DresdenGman/code-rain-ring/docs/design_notes_v7.md

# CodeRain v7 (size M, ID 20.6 ≈ US 11)
- Display: 0.66" 64x48 SSD1306 white, panel 18.46 (Y) x 18.1 (X) x 1.25, 28-pin 0.65 FPC folding down from the −X edge to the back of the panel
- Face 25.2x21.8 (ratio 1.16 ≈ reference 21x18), metal bezel ≈1.1; parallel sides, head 4.5 above the bore
- Display pocket 18.8x18.9x1.3 (z13.1–14.4); cover recess 23.0x19.6 R1.2, depth 0.4
- Battery cavities y±9.8~11.8, z5.0~13.05, length 20.2; holds 020815 (body 15, no protection board, tabs ≈6 bent); 0.05 gap between battery top and display pocket floor
- PCB 19.6x19.2x0.4 at z12.4–12.8; magnetic socket Φ4.1 at the centre of the bottom lid
- Volume: body 3199.7 + lid 189.6 = 3389 mm³; shell weight 316L ≈27 g / Ti ≈15 g / 925 silver ≈35 g, + parts ~2.5 g (est)
- I2C wiring: BS0=0 BS1=1 BS2=0, CS#=GND, D/C#=GND (0x3C), D0=SCL, D1+D2=SDA; VBAT to battery (internal charge pump)
- Battery: the cavity fits at most ~2.0x8x(≤17 body); thicker needs a wider face or thinner outer wall; 020815 is still recommended
