DresdenGman/code-rain-ring/hardware/L/v10_L_glass_outline.png

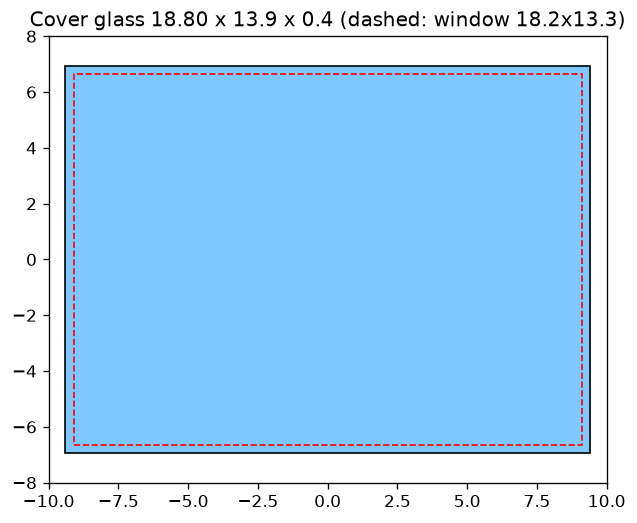
hardware/L/v10_L_glass_outline.png
