DresdenGman/code-rain-ring/hardware/L/v10_L_strip_flat.png

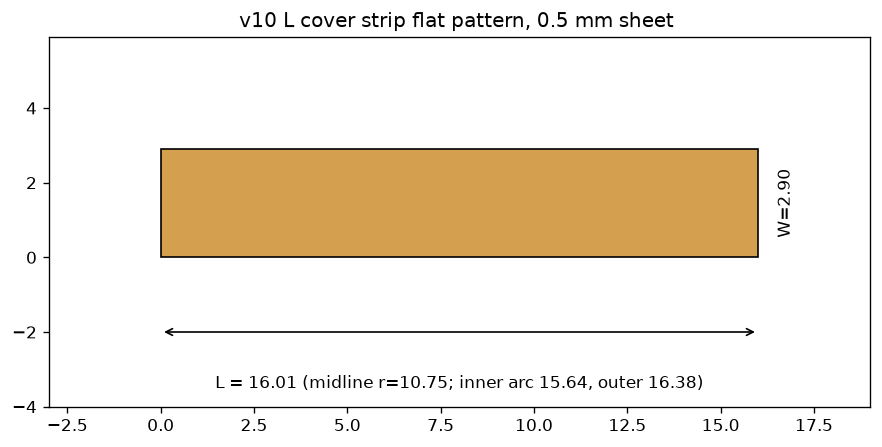
hardware/L/v10_L_strip_flat.png
