DresdenGman/code-rain-ring/hardware/M/v10_M_glass_outline.png

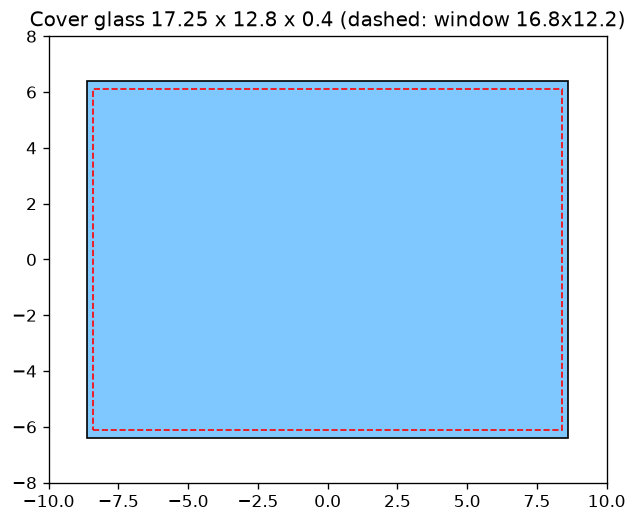
hardware/M/v10_M_glass_outline.png
