DresdenGman/code-rain-ring/hardware/M/v10_M_strip_flat.png

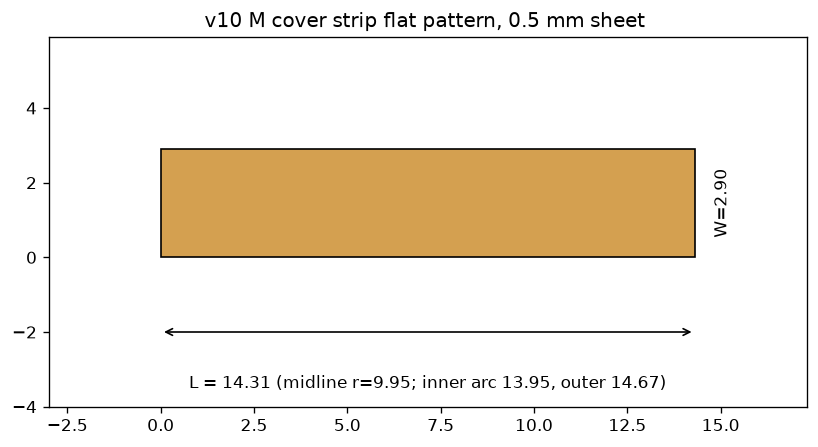
hardware/M/v10_M_strip_flat.png
