DresdenGman/code-rain-ring/renders/v10_L_exploded.png

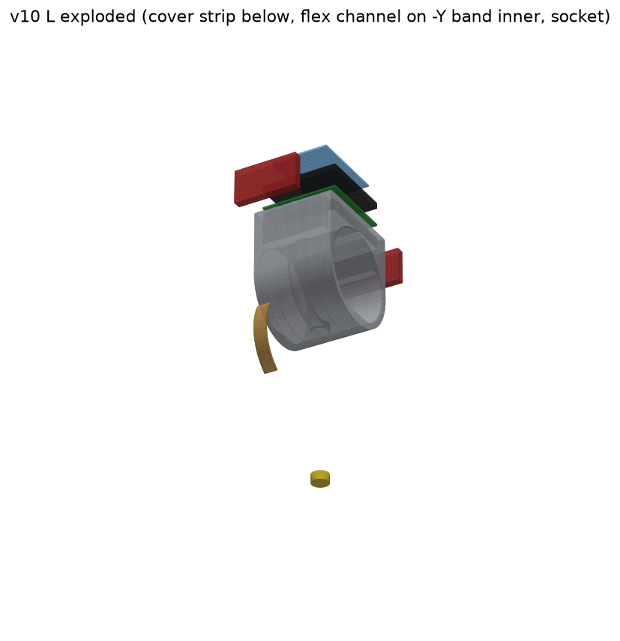
renders/v10_L_exploded.png
