DresdenGman/code-rain-ring/renders/v10_L_iso.png

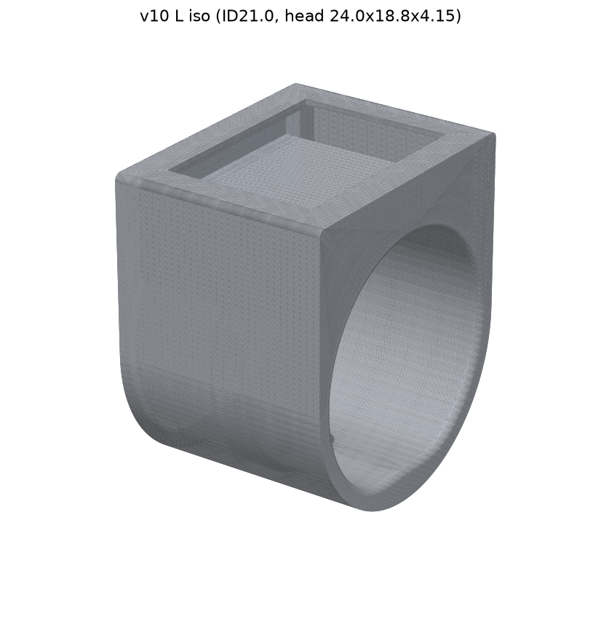
renders/v10_L_iso.png
