DresdenGman/code-rain-ring/renders/v10_L_pad.png

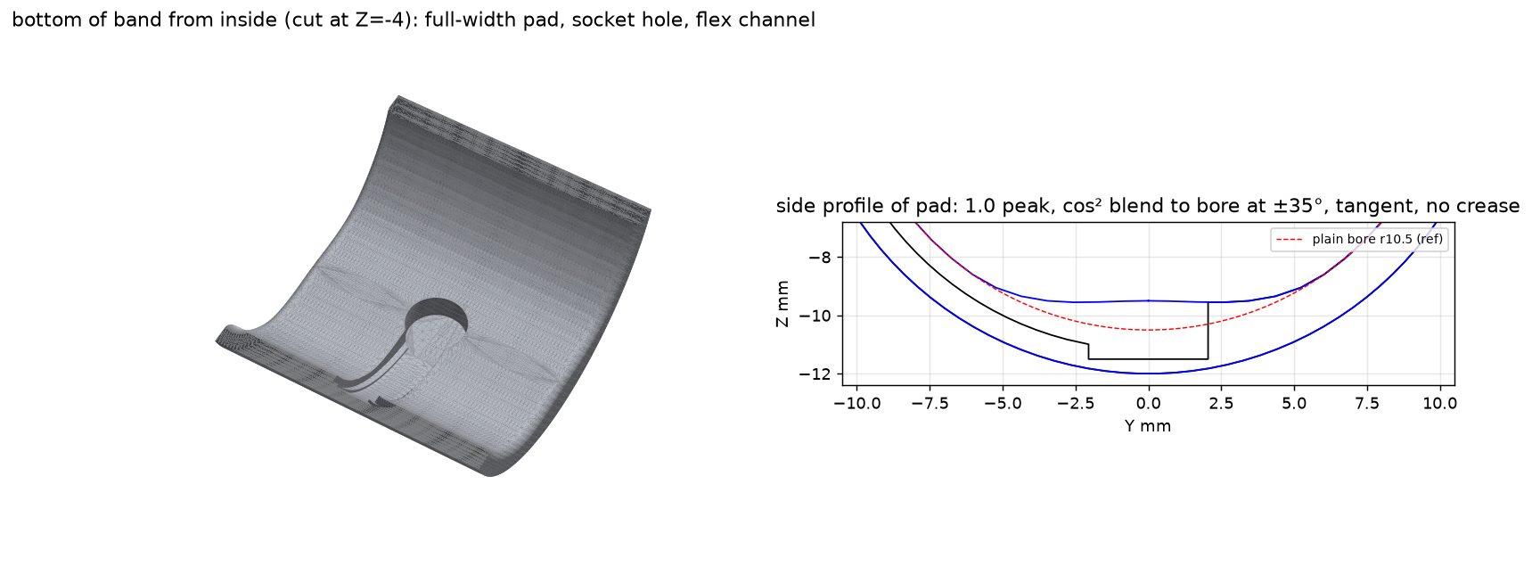
renders/v10_L_pad.png
