DresdenGman/code-rain-ring/renders/v10_L_top.png

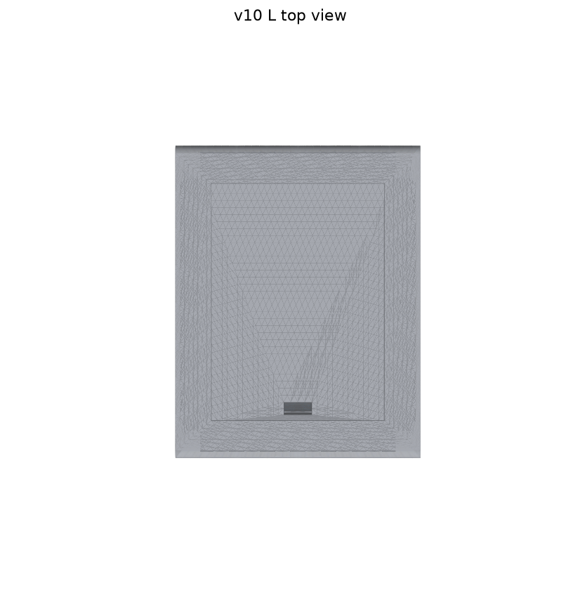
renders/v10_L_top.png
