DresdenGman/code-rain-ring/archive/bom/BOM_v1_final.csv

Category | Ref/Purpose | Part | Package/Size (mm) | Qty | LCSC number or Taobao keyword | Est. unit price | Notes
MCU | U1 | ATtiny1616-MNR (tinyAVR 1-series no radio) | QFN-20 3x3x0.9 | 1 | C507118 | ~CNY 4-6 | Runs directly from LiPo at 1.8-5.5V; power-down sleep ~0.1µA; Arduino: megaTinyCore; single-wire UPDI programming (test points on PCB)
MCU alt | U1 | CH32V003F4U6 | QFN-20 3x3 | 0 | C5299908 | ~CNY 0.6 | Cheap; official Arduino core; but min. operating voltage 2.7V (little margin at end of LiPo discharge) and higher standby current than ATtiny -> alternative
Wake | U2 | SC7A20 3-axis accelerometer (tap/double-tap interrupt -> MCU INT) | LGA-12 2x2x1 | 1 | C19274408 | ~CNY 1 | Chinese part; register-compatible with LIS2DH12
Wake alt | U2 | LIS2DH12TR | LGA-12 2x2x1 | 0 | C110926 | ~CNY 3-5 | ST original
Charging | U3 | TP4054 linear charger ~15mA | SOT-23-5 | 1 | C382138 | ~CNY 0.3 | R_PROG=68kΩ (estimate I≈1000V/R)
Program resistor | R1 | 68kΩ 1% 0402 | 0402 | 1 | LCSC basic library | —
Battery protection | U4/U5 | XB5353A single-chip protection (built-in MOSFET) | SOT-23-5 | 2 | C80628 | ~CNY 0.3 | One per cell
LDO | U6 | XC6206P302MR 3.0V low quiescent (~1µA) | SOT-23 | 1 | LCSC search XC6206P302MR | ~CNY 0.2 | Supplies OLED/MCU/accelerometer; confirm part number before ordering
Input protection | D1 | Schottky diode in series with VIN | SOD-923/0201 | 1 | LCSC basic library | — | Magnetic contacts go to VIN; not directly to the battery
ESD | D2 | ESD TVS 5V | 0201/SOD-882 | 1 | LCSC basic library | —
Display | DS1 | Zhongjingyuan 0.66in OLED 64x48 white bare panel ST7315 14-pin solder FPC | Panel 16.5x16.2x1.23 (±0.2) cap 16.5 polarizer 15.9 VA 14.42x11.06 AA 13.42x10.06; FPC neck 7.5 tail 9.0 extends 10.5; 14 pins pitch 0.62 (span 8.06) finger width 0.32 | 1 | Taobao: Zhongjingyuan Electronics 0.66in OLED 64x48 14pin solder | ~CNY 8-12 (est.) | v1 frozen; FPC exits the -X edge of the panel and folds under it; drag-soldered to 14 pads on the PCB top; VDD 2.4-3.3V; internal boost VBAT 3.5-4.2V
Charging port | J1 | WIRE cx-4mm-jz 4mm round magnetic receptacle (on hand) | Φ4 x 2.0 (rear step Φ3.7) face: outer ring Φ2.2 (−) centre pin Φ1 (+) | 1 | Pinduoduo/Taobao: 4mm round magnetic receptacle cx-4mm | — | Fits the Φ4.1 hole in the bottom lid; face toward the finger; rear pads soldered to the PCB bottom; matching USB magnetic cable (on hand)
Battery | BT1/BT2 | LIP-020815 LiPo 3.7V 9mAh | 2.0x8x15 (cell body 15 excluding protection board; tabs ~6 bent) | 2 | 1688: 200815 lithium battery / https://www.1688.com/industry/-ib9mk6.html | ~CNY 12 each | One per side battery cavity (y=±9.5~11.5 z5.6~13.9 cavity length 19.0); total length with tabs bent ≤18; no protection board; verify with samples
PCB | PCB1 | JLCPCB 4- or 2-layer FR-4 0.4mm ENIG | 18.6x18.6 R0.8 thickness 0.4 | 1 | JLCPCB order + SMT assembly | ~CNY 50-150 per 5 prototypes (est.) | Top: 14 FPC pads pitch 0.62 pad 0.36x1.6 (span 8.06 pad area ≈8.4 wide); bottom: components + receptacle pads; battery pads on the ±Y sides
Shell | — | Body + bottom lid metal 3D print | See deliver/CodeRain_v8_metal_print.zip | 1 set | Metal 3D printing service | Quote pending
Cover | — | Glass/sapphire cover 21.2x17.6 R1.2 t0.4 black border printed on back (clear window ≈13.8x10.4) | 21.2x17.6x0.4 | 1 | Taobao: custom small sapphire/tempered glass with printed black border | Quote pending
Not used | — | TTP223 / button / USB-C | — | 0 | — | — | Not used in v1: no button hole in the shell; the only opening is the magnetic charging port
OLED support | C1(C1P-C1N) C2(C2P-C2N) | Charge pump capacitor 1µF 16V X5R | 0402 | 2 | C52923 | ~CNY 0.01 | SSD1306 internal charge pump; VBAT directly from battery (3.3-4.2V)
OLED support | C3 | VCOMH capacitor 4.7µF X5R | 0402 | 1 | C23733 | ~CNY 0.02 | VCOMH to GND
OLED support | C4 | VCC decoupling 4.7µF (charge pump output ≈7.5V; choose ≥10V/16V) | 0402 | 1 | C23733 | ~CNY 0.02 | VCC to GND close to the FPC pads
OLED support | C5 C6 | VDD/VBAT decoupling 1µF | 0402 | 2 | C52923 | ~CNY 0.01 | VDD 1µF; VBAT (internal boost needs 3.5-4.2V; direct from battery; below 3.5V brightness drops / screen off)
OLED support | C7 C8 | VDD/VBAT 0.1µF | 0402 | 2 | C1525 | ~CNY 0.01
OLED support | R2 | IREF resistor 560kΩ 1% (optional; most ST7315 panels can use internal IREF; fit or not per panel datasheet) | 0402 | 1 | LCSC search 0402WGF5603TCE (number not checked) | ~CNY 0.01 | Value per panel datasheet (typically 390k-910k); the delivered panel's datasheet governs
OLED support | R3 C9 | RES# reset RC: 10kΩ pull-up + 0.1µF | 0402 | 1 | R:C25744 / C:C1525 | — | RES# to an MCU GPIO (software reset ≥3µs); RC ensures power-on reset
OLED support | R4 R5 | I2C pull-ups 4.7kΩ | 0402 | 2 | C25900 | ~CNY 0.01 | SCL/SDA shared with the accelerometer
OLED support | — | BS strapping (I2C mode) | — | 0 | — | — | The 14-pin version only exposes I2C: interface mode / CS# / SA0 fixed inside the panel; address usually 0x3C (per seller data)
OLED support | J2 | FPC pads 14-pin solder type pitch 0.62 | Pad 0.36x1.6 span 8.06 | 0 | — | — | Pinout (Zhongjingyuan drawing): 4 C1P 5 VBAT 6 NC 7 VSS 11 SDA 12 IREF 13 VCOMH 14 VCC; 1-3/8-10 not captured in the drawing; by convention presumed 1-3=C2P/C2N/C1N 8 VDD 9 RES# 10 SCL -- get the full pinout from the seller before ordering
Passives | Others | TP4054/LDO/accelerometer decoupling etc | 0402 | 6 | C1525/C52923 | — | All LCSC numbers are common basic-library parts; verify on LCSC before ordering
