DresdenGman/code-rain-ring/hardware/L/v10_L_socket.stl

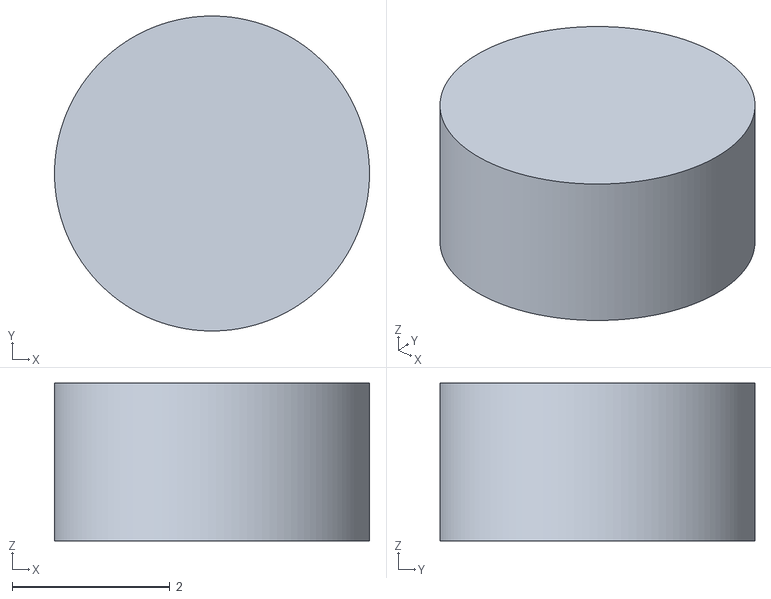
[picture p37: CAD file, 2026-11-03]
hardware/L/v10_L_socket.stl
4.00 x 4.00 x 2.00
