DresdenGman/code-rain-ring/hardware/M/v10_M_strip.step

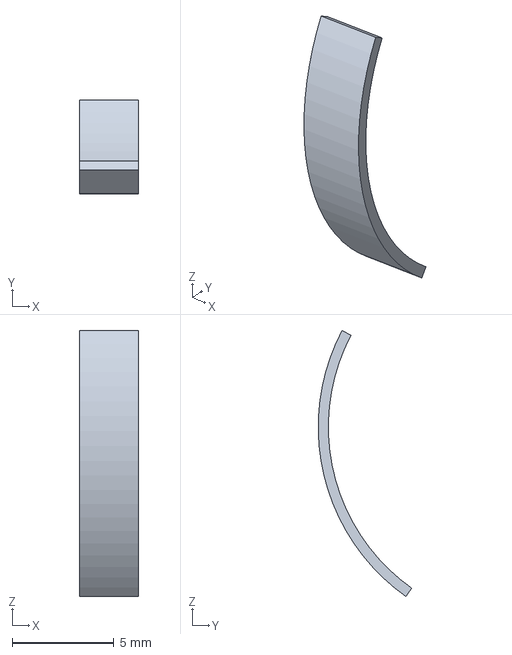
[picture p38: CAD file, 2026-11-03]
hardware/M/v10_M_strip.step
2.90 x 4.59 x 13.1 mm
