DresdenGman/code-rain-ring/hardware/L/v10_L_oled.stl

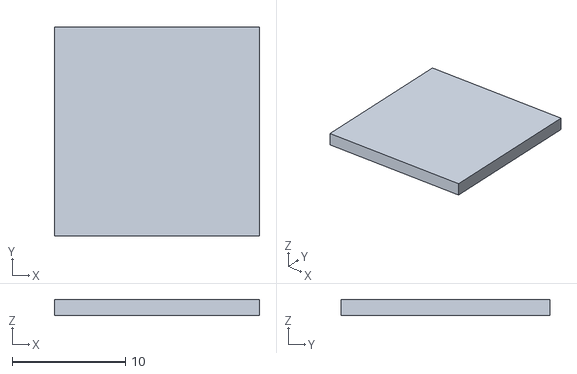
[picture p39: CAD file, 2026-11-03]
hardware/L/v10_L_oled.stl
18.1 x 18.5 x 1.45
