DresdenGman/code-rain-ring/hardware/M/v10_M_bat_L.stl

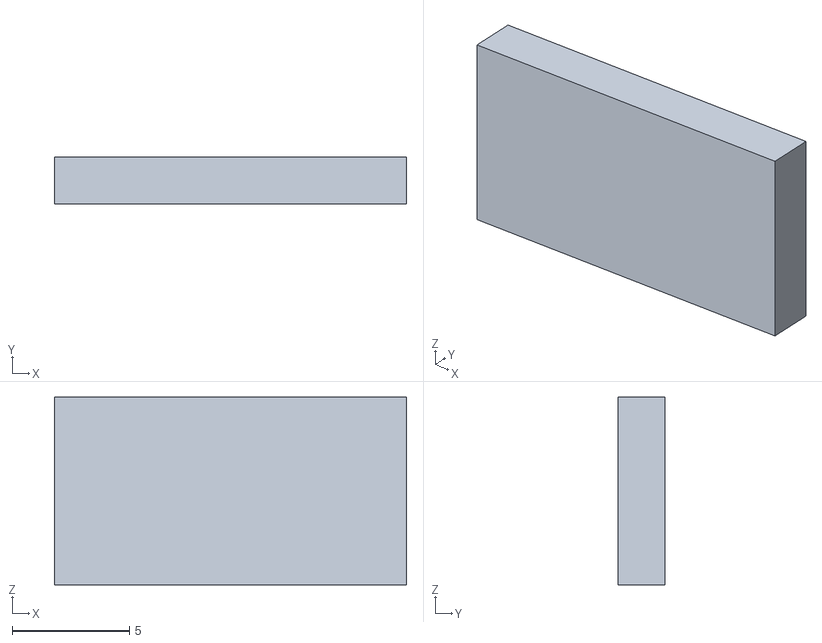
[picture p40: CAD file, 2026-11-03]
hardware/M/v10_M_bat_L.stl
15.0 x 2.00 x 8.00
