DresdenGman/code-rain-ring/hardware/L/v10_L_shell.step

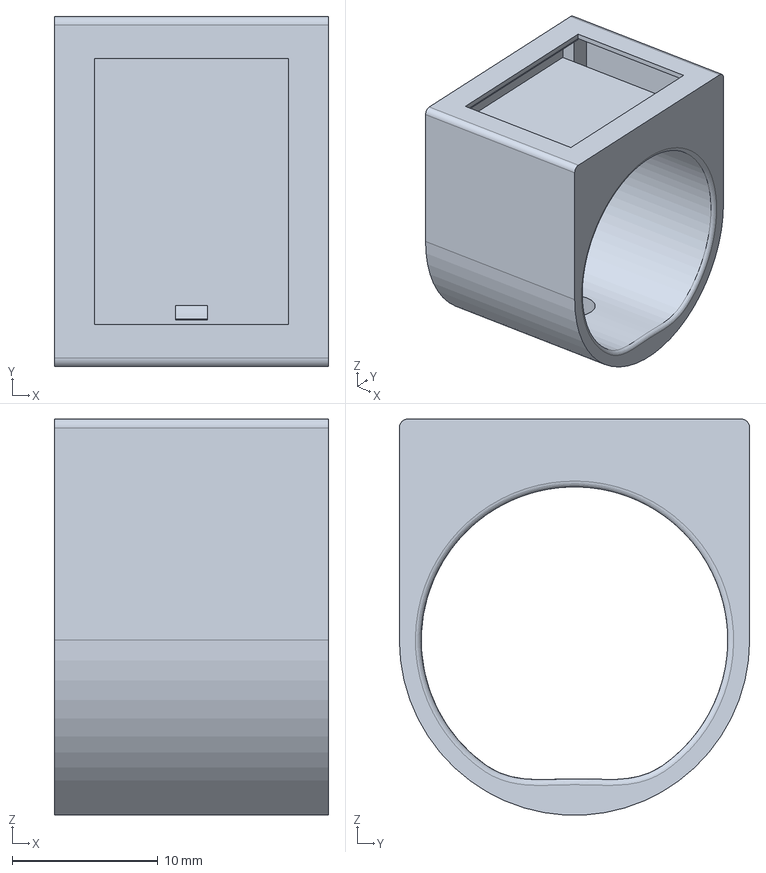
[picture p41: CAD file, 2026-11-03]
hardware/L/v10_L_shell.step
18.8 x 24.0 x 27.1 mm
