DresdenGman/code-rain-ring/hardware/M/v10_M_shell.step

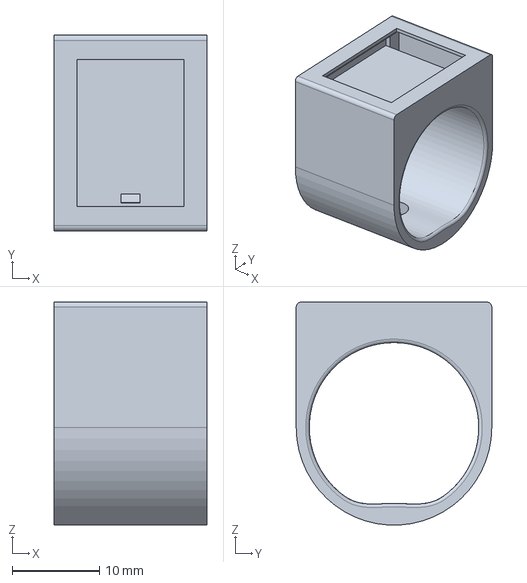
[picture p42: CAD file, 2026-11-03]
hardware/M/v10_M_shell.step
17.5 x 22.4 x 25.5 mm
