DresdenGman/code-rain-ring/hardware/L/v10_L_strip.step

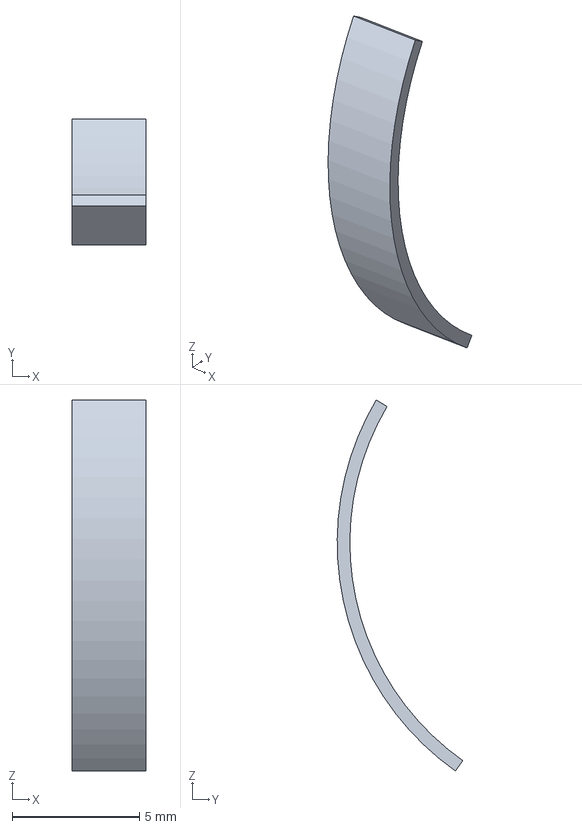
[picture p43: CAD file, 2026-11-03]
hardware/L/v10_L_strip.step
2.90 x 4.94 x 14.6 mm
