DresdenGman/code-rain-ring/hardware/M/v10_M_oled.stl

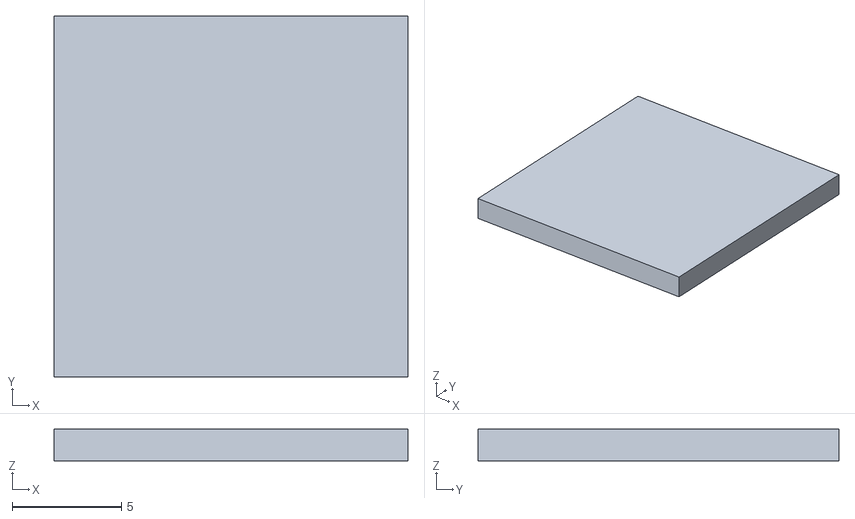
[picture p44: CAD file, 2026-11-03]
hardware/M/v10_M_oled.stl
16.2 x 16.5 x 1.45
