DresdenGman/code-rain-ring/hardware/L/v10_L_strip_flat.dxf

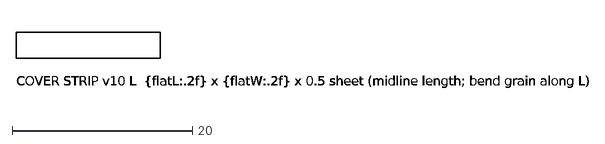
[picture p45: CAD file, 2026-11-03]
hardware/L/v10_L_strip_flat.dxf
COVER STRIP v10 L {flatL:.2f} x {flatW:.2f} x 0.5 sheet (midline length; bend grain along L)
