DresdenGman/code-rain-ring/hardware/M/v10_M_pcb.stl

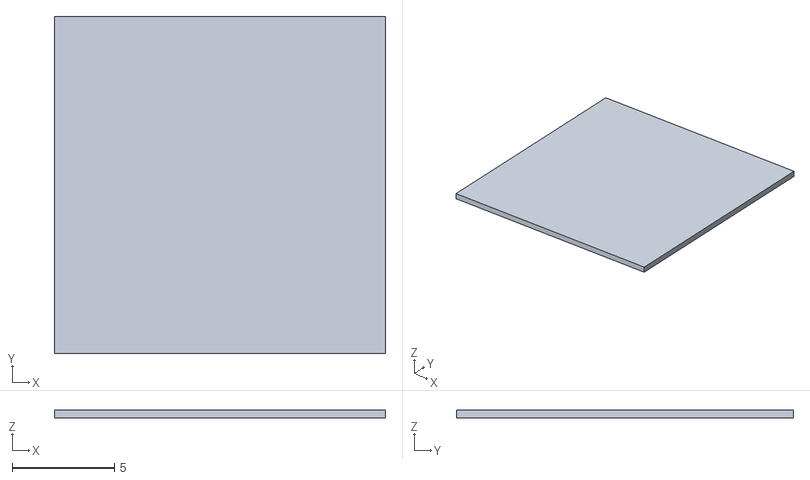
[picture p46: CAD file, 2026-11-03]
hardware/M/v10_M_pcb.stl
16.2 x 16.5 x 0.4
