DresdenGman/code-rain-ring/hardware/L/v10_L_glass.step

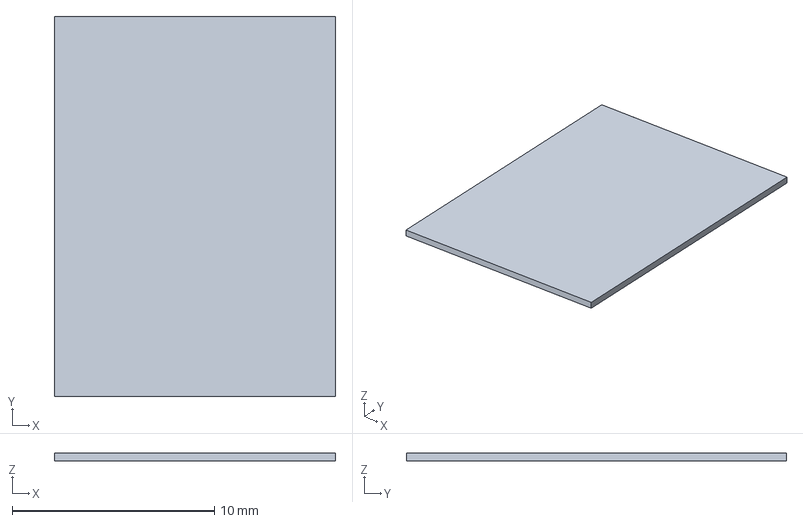
[picture p47: CAD file, 2026-11-03]
hardware/L/v10_L_glass.step
13.9 x 18.8 x 0.4 mm
