DresdenGman/code-rain-ring/hardware/M/v10_M_strip_flat.dxf

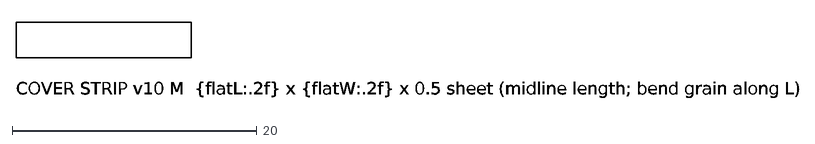
[picture p48: CAD file, 2026-11-03]
hardware/M/v10_M_strip_flat.dxf
COVER STRIP v10 M {flatL:.2f} x {flatW:.2f} x 0.5 sheet (midline length; bend grain along L)
