DresdenGman/code-rain-ring/hardware/L/v10_L_glass_outline.dxf

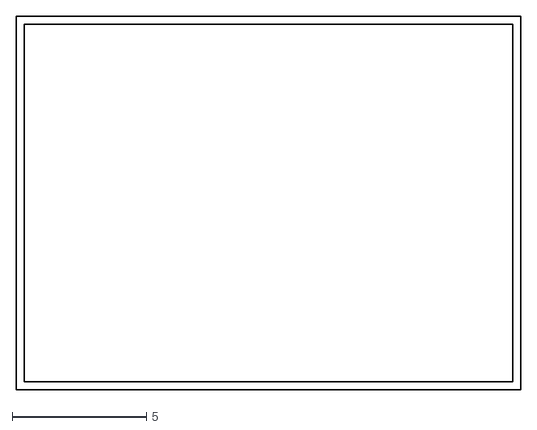
[picture p49: CAD file, 2026-11-03]
hardware/L/v10_L_glass_outline.dxf
18.8 x 13.9
