DresdenGman/code-rain-ring/hardware/M/v10_M_glass_outline.dxf

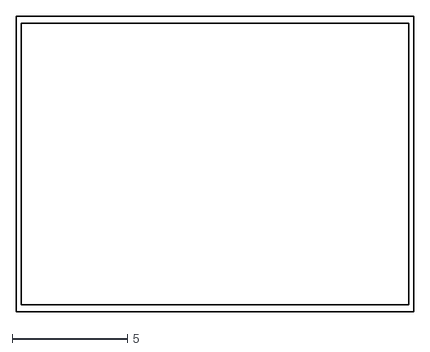
[picture p50: CAD file, 2026-11-03]
hardware/M/v10_M_glass_outline.dxf
17.2 x 12.8
