DresdenGman/code-rain-ring/hardware/L/v10_L_pcb.stl

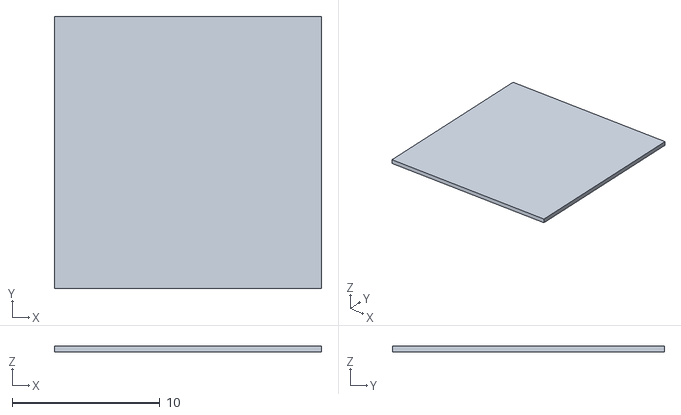
[picture p51: CAD file, 2026-11-03]
hardware/L/v10_L_pcb.stl
18.1 x 18.5 x 0.4
