DresdenGman/code-rain-ring/hardware/M/v10_M_glass.step

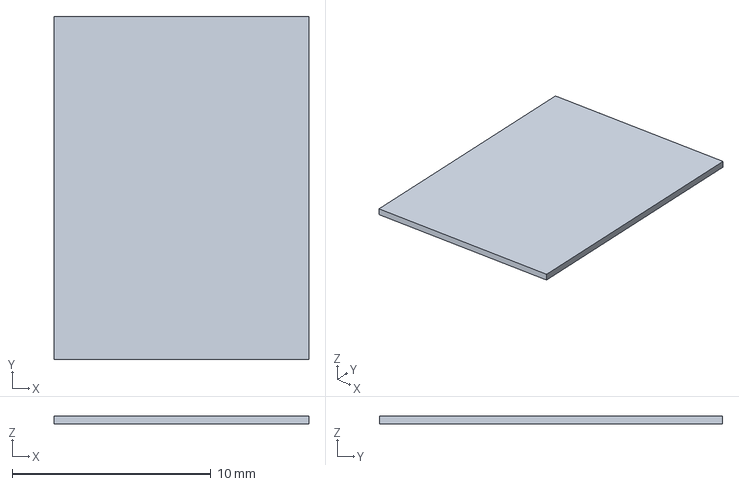
[picture p52: CAD file, 2026-11-03]
hardware/M/v10_M_glass.step
12.8 x 17.2 x 0.4 mm
