DresdenGman/code-rain-ring/(list of files, cad)

Other CAD files:
hardware/M/v10_M_bat_R.stl
hardware/L/v10_L_bat_L.stl
hardware/L/v10_L_bat_R.stl
hardware/M/v10_M_socket.stl
archive/cad/part_battery.stl
archive/cad/part_lens.stl
archive/cad/part_oled.stl
archive/cad/part_pcb.stl
archive/cad/part_usbc.stl
archive/cad/ring_lid.step
archive/cad/ring_lid.stl
archive/cad/ring_shell.step
archive/cad/ring_shell.stl
archive/cad/ring_shell_ID18.9.stl
archive/cad/ring_shell_ID22.2.stl
archive/cad/v2_head.step
archive/cad/v2_head.stl
archive/cad/v2_lid_shoulder.step
archive/cad/v2_lid_shoulder.stl
archive/cad/v2_metal_band_REFERENCE.step
archive/cad/v2_metal_band_REFERENCE.stl
archive/cad/v2_part_battery.stl
archive/cad/v2_part_lens.stl
archive/cad/v2_part_oled.stl
archive/cad/v2_part_pcb.stl
archive/cad/v2_part_usbc.stl
archive/cad/v3_bottom_lid.step
archive/cad/v3_bottom_lid.stl
archive/cad/v3_bottom_lid_lowpoly.stl
archive/cad/v3_lens.step
archive/cad/v3_lens.stl
archive/cad/v3_lens_lowpoly.stl
archive/cad/v3_section_body.stl
archive/cad/v3_section_lid.stl
archive/cad/v3_unibody_lowpoly.stl
archive/cad/v4_bottom_lid.step
archive/cad/v4_bottom_lid.stl
archive/cad/v4_bottom_lid_lowpoly.stl
archive/cad/v4_lens.step
archive/cad/v4_lens.stl
archive/cad/v4_lens_lowpoly.stl
archive/cad/v4_section_body.stl
archive/cad/v4_section_lid.stl
archive/cad/v4_unibody_lowpoly.stl
archive/cad/v5_bottom_lid.step
archive/cad/v5_bottom_lid.stl
archive/cad/v5_bottom_lid_lowpoly.stl
archive/cad/v5_lens.step
archive/cad/v5_lens.stl
archive/cad/v5_lens_lowpoly.stl
archive/cad/v5_pogo.step
archive/cad/v5_pogo.stl
archive/cad/v5_pogo_lowpoly.stl
archive/cad/v5_section_body.stl
archive/cad/v5_section_lid.stl
archive/cad/v5_section_pogo.stl
archive/cad/v5_unibody_lowpoly.stl
archive/cad/v6_bottom_lid.stl
archive/cad/v6_lens.stl
archive/cad/v6_pogo.stl
archive/cad/v6_section_lid.stl
archive/cad/v6_section_pogo.stl
archive/cad/v7_bottom_lid.stl
archive/cad/v7_lens.stl
archive/cad/v7_pogo.stl
archive/cad/v7_section_lid.stl
archive/cad/v7_section_pogo.stl
archive/cad/v8_bottom_lid.stl
archive/cad/v8_lens.stl
archive/cad/v8_pogo.stl
archive/cad/v8_section_lid.stl
archive/cad/v8_section_pogo.stl
archive/cad/v9_bottom_lid.stl
archive/cad/v9_lens.stl
archive/cad/v9_pogo.stl
archive/cad/v9_section_cap.stl
archive/cad/v9_section_lens.stl
archive/cad/v9_section_lid.stl
archive/cad/v9_section_pogo.stl
archive/cad/v9_top_bezel.stl
archive/v10_L_working/v10_L_bat_L.stl
archive/v10_L_working/v10_L_bat_R.stl
archive/v10_L_working/v10_L_glass.stl
archive/v10_L_working/v10_L_shell.stl
archive/v10_L_working/v10_L_strip.stl
archive/v10_M_working/v10_M_bat_R.stl
archive/v10_M_working/v10_M_glass.stl
archive/v10_M_working/v10_M_shell.stl
archive/v10_M_working/v10_M_socket.stl
archive/v10_M_working/v10_M_strip.stl
hardware/L/v10_L_glass.stl
hardware/L/v10_L_shell.stl
hardware/L/v10_L_strip.stl
hardware/M/v10_M_glass.stl
hardware/M/v10_M_shell.stl
hardware/M/v10_M_strip.stl
