DresdenGman/code-rain-ring/(commit log)

2026-11-03 Code Rain Ring: v10 M/L hardware, CAD, renders, promo, docs
    [BOM.csv, BOM_v1_定型.csv, BOM_v2.csv, BOM_v3.csv, BOM_v4.csv, BOM_v5.csv, BOM_v6.csv, BOM_v7.csv]
2026-11-03 Convert repository to English: translate docs and BOMs, rename files, relabel and redraw drawings, remove seller screenshots
    [BOM_v1_final.csv, BOM_v1_定型.csv, BOM_v2.csv, BOM_v3.csv, BOM_v4.csv, BOM_v5.csv, BOM_v6.csv, BOM_v7.csv]
